fontoura/InstrumentoMusical/Monografia/Source/figs/arduino.jpg

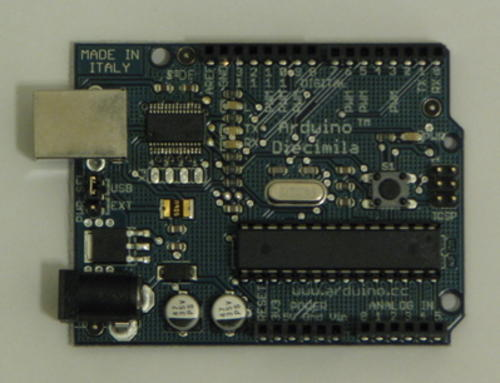
Monografia/Source/figs/arduino.jpg
