fontoura/InstrumentoMusical/Monografia/Source/figs/fotocircuito.jpg

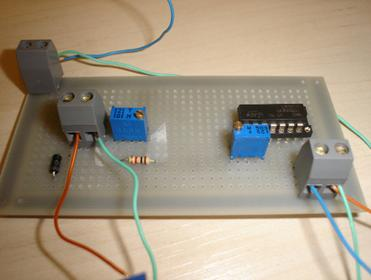
Monografia/Source/figs/fotocircuito.jpg
