fontoura/InstrumentoMusical/README.md

Software do projeto "Interface de Instrumento Musical Eletrônico" apresentado à disciplina de Oficinas de Integração 2 do curso de Engenharia de Computação do campus Curitiba da Universidade Tecnológica Federal do Paraná no segundo semestre de 2009.

Equipe:

Felipe Luiz Bill

Felipe Michels Fontoura

Leandro Piekarski do Nascimento

Lucio Eiji Assaoka Hossaka

BILL, Felipe Luiz; DO NASCIMENTO, Leandro Piekarski; FONTOURA, Felipe Michels; HOSSAKA, Lucio Eiji Assaoka. Interface de Instrumento Musical Eletrônico. 32 f. Trabalho Acadêmico – Curso de Engenharia de Computacão, Universidade Tecnológica Federal do Paraná. Curitiba, 2009.
