fontoura/InstrumentoMusical/Monografia/Source/figs/ampop.png

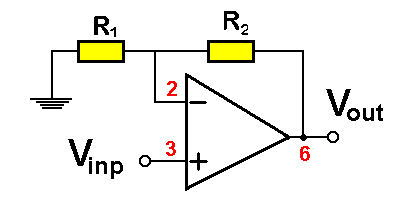
Monografia/Source/figs/ampop.png
